fortalbrz/aquarioino/wellspring/img/image_no_bg.png

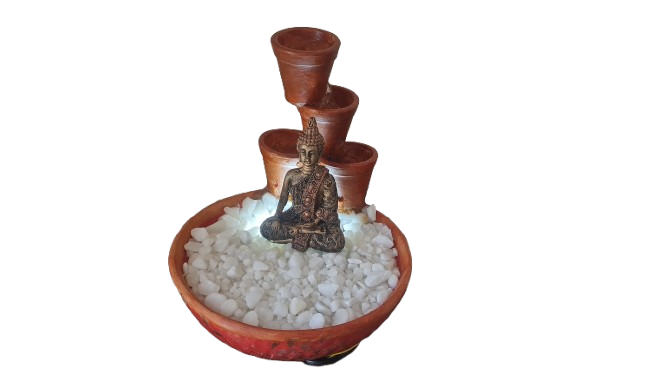
wellspring/img/image_no_bg.png
