fortalbrz/aquarioino/(commit log)

2023-09-23 adding Home Assistant
    // TODO:
    // - programmagle timers
    // - programmagle timers commands
    // - eeprom
    // - states with relays / timers
2023-09-26 RC01 - missing feeder locker logic testing
    [aquarioino.ino]
2023-09-29 v 2.0 RC02 - finishing feeder logic, stepper motor feeder and docs
2023-10-30 adding feature to light project: betaino (turn on/off sump pump in regular intervals)
2023-11-06 adding stepper motor driver ULN2003
    adding stepper motor driver ULN2003
2024-10-02 Updating low water level sensor times
2024-10-22 addin ArduinoJson lib
